prydin/hdr/pcb/adc_fpga/CmodS7.step

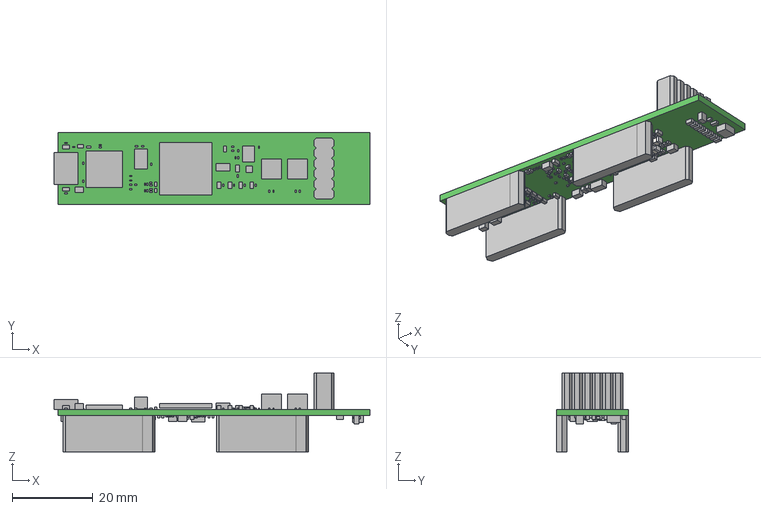
[picture p1: CAD file, 2024-06-10]
pcb/adc_fpga/CmodS7.step
78.4 x 17.8 x 19.6 mm
Board
Extruded x 243
