prydin/hdr/pcb/adc_fpga/symbols/RF2-03N-T-00-50-G-RP.stp

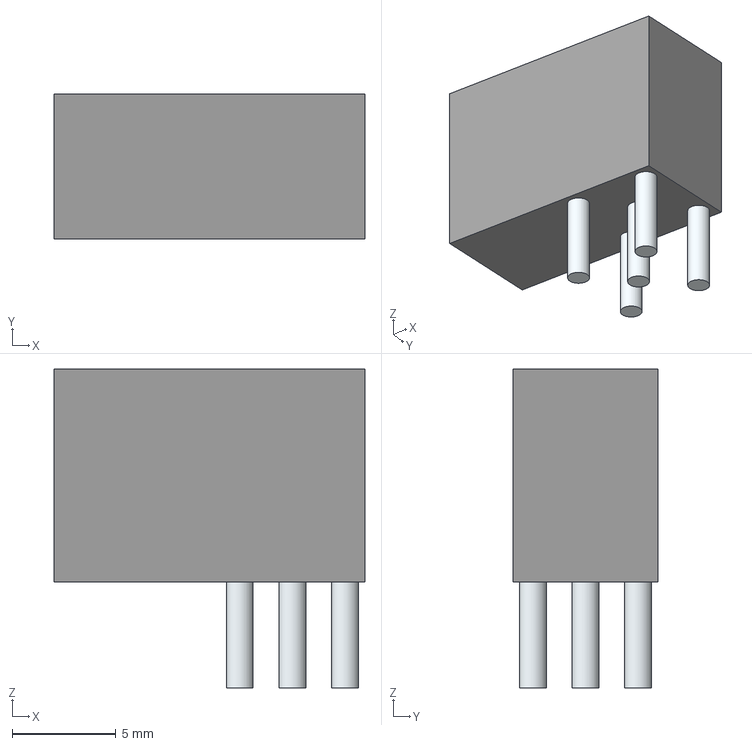
[picture p2: CAD file, 2024-06-10]
pcb/adc_fpga/symbols/RF2-03N-T-00-50-G-RP.stp
15.0 x 7.00 x 15.4 mm
Leads
