prydin/hdr/pcb/adc_fpga/symbols/MAX4230AXK.step

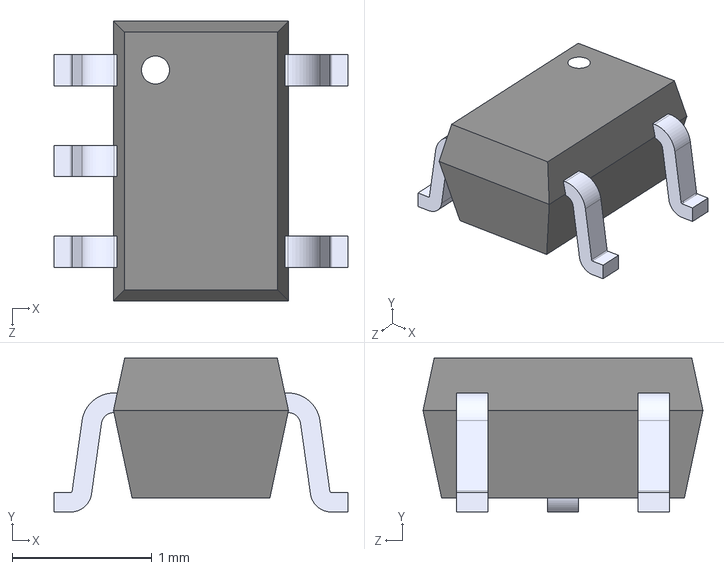
[picture p3: CAD file, 2024-06-10]
pcb/adc_fpga/symbols/MAX4230AXK.step
2.10 x 1.10 x 2.00 mm
