prydin/hdr/pcb/adc_fpga/symbols/ZMR330FTA.step

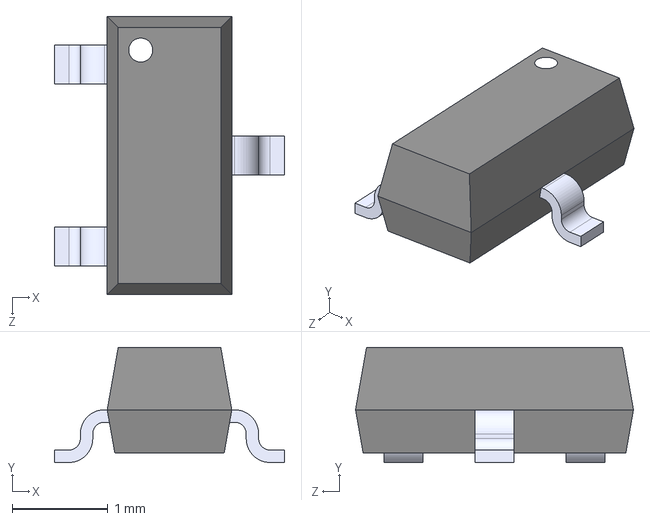
[picture p4: CAD file, 2024-06-10]
pcb/adc_fpga/symbols/ZMR330FTA.step
2.40 x 1.20 x 2.90 mm
