prydin/hdr/pcb/filter_pcb/filter/filter.kicad_pcb

## KiCad design pcb/filter_pcb/filter/filter.kicad_pcb (2024-06-25)

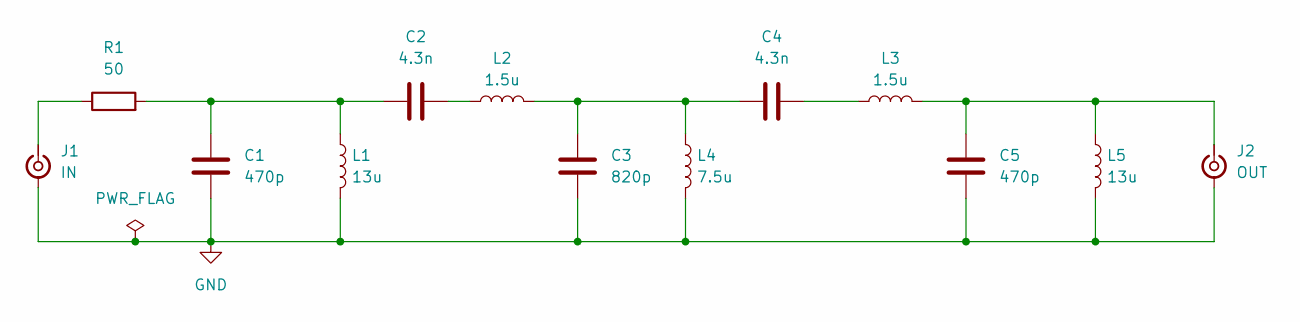
[picture p5: schematic filter.kicad_sch]

Parts:
C1, C5: 470p; C_Disc_D3.8mm_W2.6mm_P2.50mm
C2, C4: 4.3n; C_Disc_D3.8mm_W2.6mm_P2.50mm
C3: 820p; C_Disc_D3.8mm_W2.6mm_P2.50mm
J1: IN; SMA_Amphenol_901-144_Vertical
J2: OUT; SMA_Amphenol_901-144_Vertical
L1, L5: 13u; L_Toroid_Vertical_L10.0mm_W5.0mm_P5.08mm
L2, L3: 1.5u; L_Toroid_Vertical_L10.0mm_W5.0mm_P5.08mm
L4: 7.5u; L_Toroid_Vertical_L10.0mm_W5.0mm_P5.08mm
R1: 50; R_Axial_DIN0204_L3.6mm_D1.6mm_P7.62mm_Horizontal

Connections:
GND: C1.2, C3.1, C5.2, J1.2 (Ext), J2.2 (Ext), L1.2, L4.2, L5.2
unnamed: C3.2, C4.1, L2.2, L4.1
unnamed: C1.1, C2.1, L1.1, R1.2
unnamed: C2.2, L2.1
unnamed: C4.2, L3.1
unnamed: J1.1 (In), R1.1
unnamed: C5.1, J2.1 (In), L3.2, L5.1

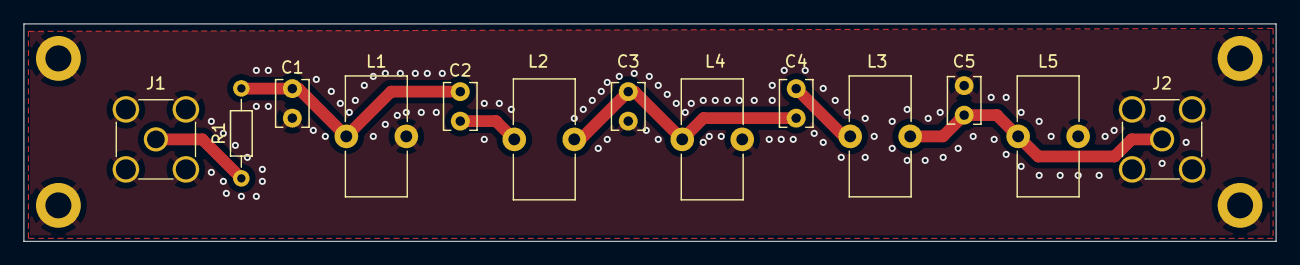
[picture p6: board filter.kicad_pcb from above]

Board: 2 copper layers, 106.0 x 18.4 mm, 13 parts (0 on the bottom side), 7 nets.
