prydin/hdr/pcb/adc_fpga/adc_fpga.kicad_pcb

## KiCad design pcb/adc_fpga/adc_fpga.kicad_pcb (2024-06-25)

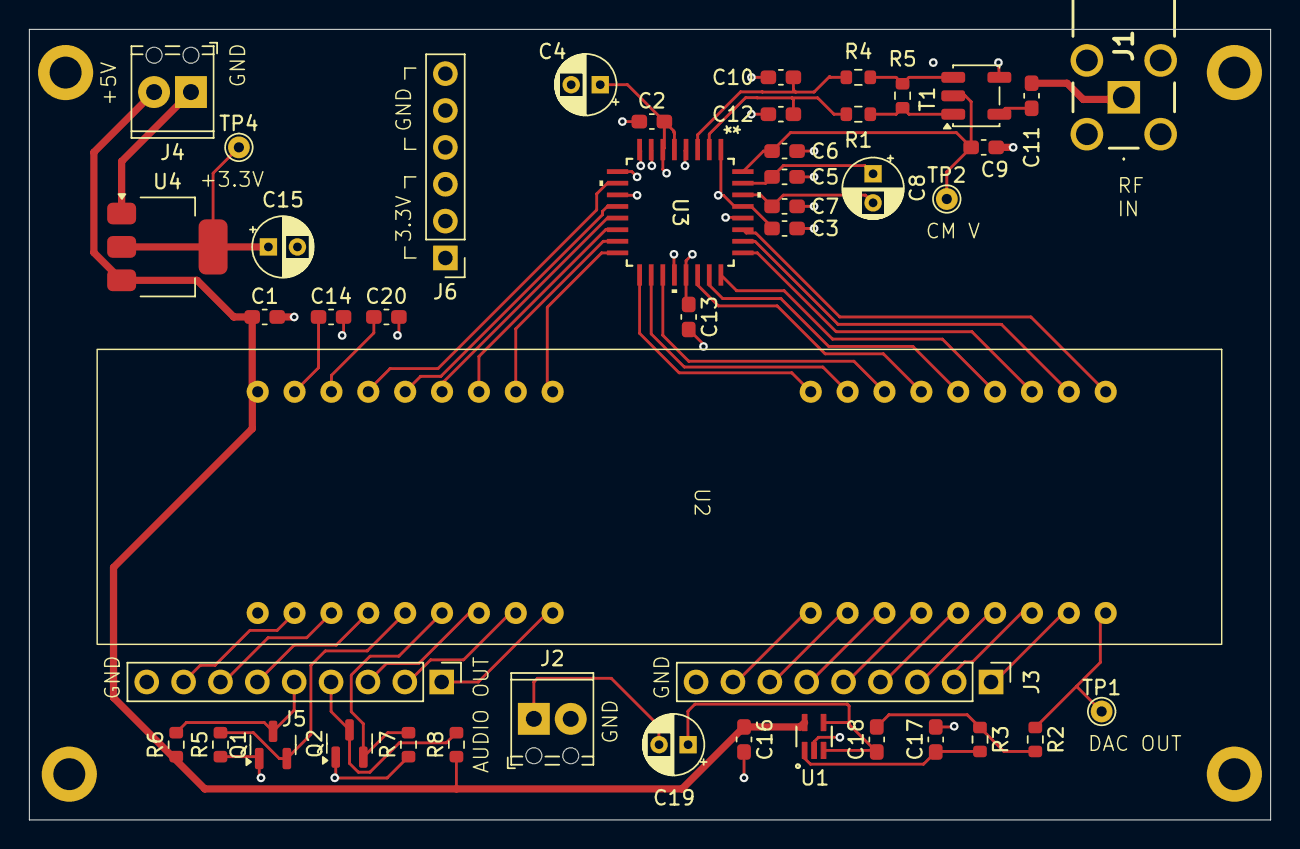
[picture p7: board adc_fpga.kicad_pcb from above]

Board: 4 copper layers, 85.5 x 54.5 mm, 45 parts (0 on the bottom side), 52 nets.

Parts:
C1, C2, C3, C5, C6, C7, C9, C11, C13, C14, C16, C20: 100n; C_0603_1608Metric_Pad1.08x0.95mm_HandSolder
C4, C8, C15, C19: 10u; CP_Radial_D4.0mm_P2.00mm
C10, C12: 100p; C_0603_1608Metric_Pad1.08x0.95mm_HandSolder
C17: 470p; C_0603_1608Metric_Pad1.08x0.95mm_HandSolder
C18: 1n; C_0603_1608Metric_Pad1.08x0.95mm_HandSolder
J1: RF_IN; RF203NT0050GRP
J2, J4: TerminalBlock_Phoenix_MPT-0,5-2-2.54_1x02_P2.54mm_Horizontal
J3, J5: AUX I/O; PinHeader_1x09_P2.54mm_Vertical
J6: PinHeader_1x06_P2.54mm_Vertical
Q1, Q2: BSS138; SOT-23
R1, R4: 33; R_0603_1608Metric
R2, R5#2, R6, R7, R8: 10k; R_0603_1608Metric
R3: 15k; R_0603_1608Metric
R5: 50; R_0603_1608Metric
T1: Transformer_MiniCircuits_AT224-1A
TP1: DAC OUT; TestPoint_THTPad_D1.5mm_Drill0.7mm
TP2: CM; TestPoint_THTPad_D1.5mm_Drill0.7mm
TP4: +3.3V; TestPoint_THTPad_D1.5mm_Drill0.7mm
U1: MAX4230AXK; SOT65P210X110-5N
U2: CMOD S7
U3: ADC14L020CIVY/NOPB; VBE32A_TEX
U4: TLV76133DCY; SOT-223-3_TabPin2

Connections:
+3.3V: C2.2, C3.2, C4.1, C13.1, C15.1, J6.1, J6.2, J6.3, Q1.1 (G), Q2.1 (G), R5#2.1, R7.1, TP4.1, U3.1 (VREF), U3.5 (VA), U3.6 (VD), U3.21 (VDR), U3.29 (VA), U4.2 (VO)
+5V: C1.1, C16.1, J4.2, R6.1, R8.1, U1.5 (V+), U2.24 (VU), U4.3 (VI)
GND: C1.2, C2.1, C3.1, C4.2, C5.1, C6.1, C7.1, C9.2, C10.1, C12.2, C13.2, C14.2, C15.2, C16.2, C17.2, C20.2, J1.2 (Ext), J2.2, J3.9, J4.1, J5.9, J6.4, J6.5, J6.6, T1.4, U1.2 (V-), U2.25 (GND), U3.4 (AGND), U3.7 (AGND), U3.8 (PD), U3.9 (DGND), U3.11 (DF/DCS), U3.20 (DRGND), U3.28 (AGND), U4.1 (GND)
unnamed: C11.2, T1.6
unnamed: C18.2, R2.2, R3.1
unnamed: C11.1, J1.1 (In)
unnamed: C19.2, J2.1
unnamed: R1.2, R5.1, T1.1
unnamed: R4.2, R5.2, T1.3
unnamed: C17.1, R3.2, U1.1 (+)
unnamed: C18.1, C19.1, U1.3 (-), U1.4
unnamed: J3.7, U2.41 (A2)
unnamed: J3.1, U2.47 (A3)
unnamed: R2.1, TP1.1, U2.48 (A4)
unnamed: J5.2, U2.32 (A32)
unnamed: J5.1, U2.33 (A33)
unnamed: J3.5, U2.43 (B1)
unnamed: J3.6, U2.42 (B2)
unnamed: J3.3, U2.45 (B3)
unnamed: J3.2, U2.46 (B4)
unnamed: J3.4, U2.44 (C1)
unnamed: J3.8, U2.40 (C5)
unnamed: J5.3, U2.31 (J11)
unnamed: J5.6, U2.28 (J15)
unnamed: J5.7, U2.27 (K14)
unnamed: U2.1 (L1), U3.27 (D13(MSB))
unnamed: J5.8, U2.26 (L14)
unnamed: C14.1, U2.23 (L15)
unnamed: U2.5 (M2), U3.23 (D9)
unnamed: U2.3 (M3), U3.25 (D11)
unnamed: U2.2 (M4), U3.26 (D12)
unnamed: C20.1, U2.22 (M14)
unnamed: U2.21 (M15), U3.10 (CLK)
unnamed: U2.9 (N1), U3.17 (D5)
unnamed: U2.4 (N2), U3.24 (D10)
unnamed: U2.7 (N3), U3.19 (D7)
unnamed: U2.18 (N13), U3.14 (D2)
unnamed: U2.20 (N14), U3.12 ((LSB)D0)
unnamed: U2.19 (N15), U3.13 (D1)
unnamed: U2.8 (P1), U3.18 (D6)
unnamed: U2.6 (P3), U3.22 (D8)
unnamed: U2.16 (P14), U3.16 (D4)
unnamed: U2.17 (P15), U3.15 (D3)
unnamed: C12.1, R1.1, U3.2 (VIN+)
unnamed: C10.2, R4.1, U3.3 (VIN-)
unnamed: C6.2, C9.1, T1.2, TP2.1, U3.32 (VRM)
unnamed: C7.2, C8.2, U3.30 (VRN)
unnamed: C5.2, C8.1, U3.31 (VRP)
SCL3.3V: Q1.2 (S), R5#2.2, U2.29 (L13)
SCL5V: J5.5, Q1.3 (D), R6.2
SDA3.3V: Q2.2 (S), R7.2, U2.30 (M13)
SDA5V: J5.4, Q2.3 (D), R8.2
