prydin/hdr/src/hw/design/rtl/controller.v

`timescale 1ns / 1ps

module monostable_ff
    #(CYCLES = 1        // Number of cycles to keep output high after positive flank on d
    ) (
    input wire aclk,    // System clock
    input wire reset,   // Master reset
    input wire d,       // Data in
    output reg q = 0);  // Data out
    
    reg [$clog2(CYCLES + 1) - 1: 0] counter = CYCLES;
    reg prev = 0;
    
    always @(posedge aclk) 
    begin
        if(reset)
        begin
            counter <= CYCLES;
            prev <= d;
            q <= 0;
        end else begin
            // Positive flank?
            if(prev == 0 && d == 1)
            begin
                // Set output high and start counting down time to reset
                q <= 1;
                counter <= CYCLES;
            end else begin
                if(q == 1) 
                begin
                    counter <= counter - 1;
                    if(counter == 0) 
                    begin
                        // Reset time reached
                        q <= 0;  
                    end
                end
            end
            prev <= d;
        end
    end
endmodule

module controller #(parameter PHASE_INC_WIDTH = 27) (
        input wire aclk,
        input wire clk_locked,
        input wire reset,
        input wire fq_ck,
        input wire fq_dt,
        output reg [PHASE_INC_WIDTH - 1:0] phase_inc = 8388608, // Start at 1MHz to avoid DDS going bonkers
        output wire phase_inc_valid,
        inout wire iic_scl,
        inout wire iic_sda,
        input wire uart_rx,
        output wire uart_tx
    );
    
    reg fq_read_enable = 0;
   
    
    // Frequency dial
    wire fq_valid;
    wire signed [7:0] fq_change; 
    rotary_enc fq_dial (
        .aclk(aclk),
        .reset(reset),
        .ck(fq_ck),
        .dt(fq_dt),
        .read_enable(fq_read_enable),
        .out(fq_change),
        .out_valid(fq_valid)
    );
       
   // Commands from MCU to FPGA
   localparam GET_FQ_INC    = 4'h1;                 // Get latest frequency increment
   localparam SET_PHASE_INC = 4'h2;                 // Set phase increment
   localparam NO_COMMAND    = 4'h0;                 // No command -> Get ready for next
   
    reg [31:0] to_mcu = 32'h0;
    wire [31:0] from_mcu;
    wire [3:0] command_from_mcu = from_mcu[31:28];
    wire [27:0] data_from_mcu = from_mcu[27:0];
    reg ready = 1;
    
    
    wire iic_scl_i;
    wire iic_scl_o;
    wire iic_scl_t;
    wire iic_sda_i;
    wire iic_sda_o;
    wire iic_sda_t;
    
    // Replicating parts of the wrapper instead of using the wrapper 
    // itself, as it seems to confuse Vitis.
    IOBUF iic_scl_iobuf
       (.I(iic_scl_o),
        .IO(iic_scl),
        .O(iic_scl_i),  
        .T(iic_scl_t));
    IOBUF iic_sda_iobuf
       (.I(iic_sda_o),
        .IO(iic_sda),
        .O(iic_sda_i),
        .T(iic_sda_t));  
        
        /*
    assign iic_sda = iic_sda_t || iic_sda_o ? 1'bz : 1'b0;
    assign iic_sda_i = iic_sda; 
    assign iic_scl = iic_scl_t || iic_scl_o ? 1'bz : 1'b0;
    assign iic_scl_i = iic_scl; */

    mcu mcu
        (.aclk(aclk),
        .from_mcu_tri_o(from_mcu),
        .iic_scl_i(iic_scl_i),
        .iic_scl_o(iic_scl_o),
        .iic_scl_t(iic_scl_t),
        .iic_sda_i(iic_sda_i),
        .iic_sda_o(iic_sda_o),
        .iic_sda_t(iic_sda_t),
        .locked(clk_locked),
        .to_mcu_tri_i(to_mcu),
        .usb_uart_rxd(uart_rx),
        .usb_uart_txd(uart_tx));
                
    // Monostable ff to make sure phase_valid is long enough for the
    // slower clocked DDS to pick up. Keep high for two DDS clock cycles
    reg raw_phase_inc_valid = 0;
    monostable_ff #(.CYCLES(256 / 16)) phase_valid_ff(
        .aclk(aclk),
        .d(raw_phase_inc_valid),
        .q(phase_inc_valid));
        
        
    // Command dispatcher state machine
    localparam IDLE         = 4'h0;     // Awaiting command
    localparam EXECUTE      = 4'h1;     // Command is executing
    localparam LIMBO        = 4'h2;     // Stalled until NO_COMMAND received TODO: Remmove this? 
    reg [3:0] state = IDLE;
    always @(posedge aclk or posedge reset)
    begin
        if(reset) 
        begin
            ready <= 1;
            to_mcu <= 0;
        end else begin 
            case(command_from_mcu)
            GET_FQ_INC:
                case(state)
                IDLE:
                    begin
                        fq_read_enable <= 1;
                        state <= EXECUTE; 
                    end
                EXECUTE:
                    begin
                        if(fq_valid) 
                        begin
                            to_mcu <= {{24{fq_change[7]}}, fq_change };
                            fq_read_enable <= 0;
                            state <= LIMBO;
                        end
                    end
                endcase
                SET_PHASE_INC:
                case(state)
                IDLE:
                    begin
                        phase_inc <= data_from_mcu[PHASE_INC_WIDTH - 1:0];
                        raw_phase_inc_valid <= 1;
                        state <= EXECUTE;
                    end
                EXECUTE:
                    begin
                        raw_phase_inc_valid <= 0;
                        state <= LIMBO;
                    end
                endcase
            NO_COMMAND:
                begin
                    state <= IDLE;
                end
            endcase
        end
     end
endmodule
