prydin/hdr/src/sw/.peers.ini

DefaultTarget=true
ServiceManagerID=2cdd9f93-e12f-4e99-afd4-6c5f9203b019
TransportName=TCP
AutoSetJtagFrequency=false
PeerTypeId=LINUX_EMULATION
UserName=pontu
Port=1440
Host=127.0.0.1
OSName=Windows 11
ID=LinuxEmulation
AgentID=2cdd9f93-e12f-4e99-afd4-6c5f9203b019
Name=LinuxEmulation

DefaultTarget=true
ServiceManagerID=2cdd9f93-e12f-4e99-afd4-6c5f9203b019
TransportName=TCP
AutoSetJtagFrequency=false
PeerTypeId=XRT_SERVER
UserName=pontu
Port=1222
Host=127.0.0.1
OSName=Windows 11
ID=XRTServer
AgentID=2cdd9f93-e12f-4e99-afd4-6c5f9203b019
Name=XRTServer

DefaultTarget=true
ServiceManagerID=2cdd9f93-e12f-4e99-afd4-6c5f9203b019
TransportName=TCP
AutoSetJtagFrequency=true
PeerTypeId=HARDWARE_SERVER
UserName=pontu
Port=3121
Host=127.0.0.1
OSName=Windows 11
ID=Local
AgentID=2cdd9f93-e12f-4e99-afd4-6c5f9203b019
Name=Local

DefaultTarget=true
ServiceManagerID=2cdd9f93-e12f-4e99-afd4-6c5f9203b019
TransportName=TCP
AutoSetJtagFrequency=false
PeerTypeId=LINUX_TCF_AGENT
UserName=pontu
Port=1534
Host=192.168.0.1
OSName=Windows 11
ID=Linux Agent
AgentID=2cdd9f93-e12f-4e99-afd4-6c5f9203b019
Name=Linux Agent

DefaultTarget=true
ServiceManagerID=2cdd9f93-e12f-4e99-afd4-6c5f9203b019
TransportName=TCP
AutoSetJtagFrequency=false
PeerTypeId=QEMU_TCF_GDB_CLIENT
UserName=pontu
Port=1138
Host=127.0.0.1
OSName=Windows 11
ID=QEMU
AgentID=2cdd9f93-e12f-4e99-afd4-6c5f9203b019
Name=QEMU
