prydin/hdr/src/hw/design/rtl/random.v

`timescale 1ns / 1ps
//////////////////////////////////////////////////////////////////////////////////
// Company: 
// Engineer: 
// 
// Create Date: 03/10/2024 10:25:08 AM
// Design Name: 
// Module Name: random
// Project Name: 
// Target Devices: 
// Tool Versions: 
// Description: 
// 
// Dependencies: 
// 
// Revision:
// Revision 0.01 - File Created
// Additional Comments:
// 
//////////////////////////////////////////////////////////////////////////////////


module random(input clk, reset, en, output reg [7:0] q);
  always @(posedge clk or posedge reset) begin
    if (reset)
      q <= 8'd1; 
    else if (en)
      q <= {q[6:0], q[7] ^ q[5] ^ q[4] ^ q[3]}; // polynomial for maximal LFSR
  end
endmodule
