prydin/hdr/(commit log)

2024-06-10 Moved PCB designs from old project
    [CmodS7.step, MAX4230AXK.step, RF2-03N-T-00-50-G-RP.stp, ZMR330FTA.step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]
2024-06-11 Compact design
    [filter.kicad_pcb, filter.kicad_sch]
2024-06-25 LCD kind of working
    [adc_fpga-B_Cu.gbr, adc_fpga-B_Mask.gbr, adc_fpga-B_Paste.gbr, adc_fpga-B_Silkscreen.gbr, adc_fpga-Edge_Cuts.gbr, adc_fpga-F_Cu.gbr, adc_fpga-F_Mask.gbr, adc_fpga-F_Paste.gbr]
